JakubBohunicky/RoboCup/2024/Photo/tsop_PCB_V1.png

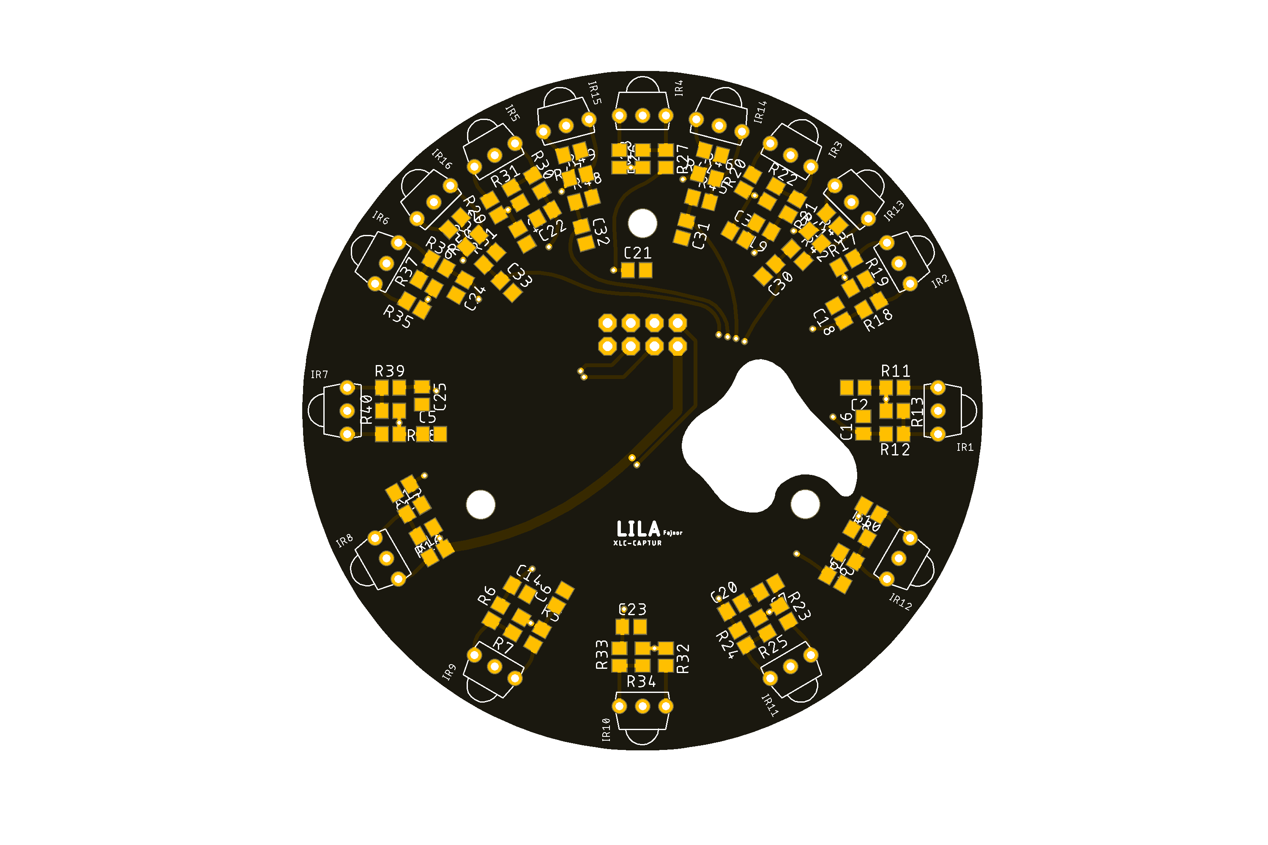
2024/Photo/tsop_PCB_V1.png
