JakubBohunicky/RoboCup/2025_Bari/test_code/tlaƒ/4ksclonynatsopnovaverzia.3mf

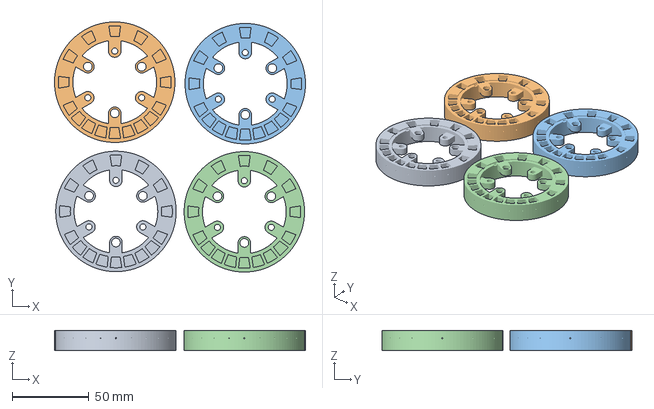
[picture p14: CAD file, 2026-10-10]
2025_Bari/test_code/tlaƒ/4ksclonynatsopnovaverzia.3mf
163.9 x 163.3 x 13.3 mm
