JakubBohunicky/RoboCup/2025_Bari/test_code/tlaƒ/kickerkolecka.3mf

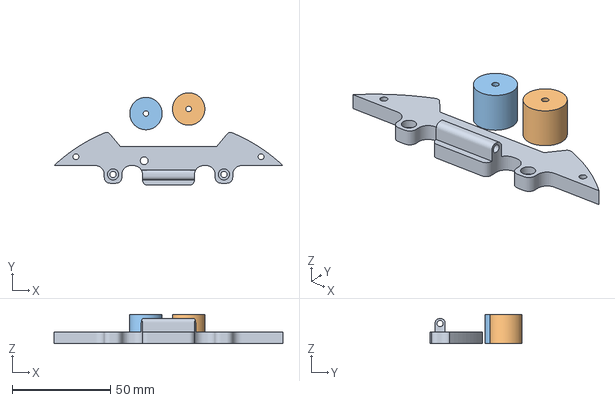
[picture p15: CAD file, 2026-10-10]
2025_Bari/test_code/tlaƒ/kickerkolecka.3mf
116.5 x 47.0 x 15.0 mm
Body59.stl
vnutronakolieskodriblera_
