JakubBohunicky/RoboCup/2025_Bari/test_code/tlaƒ/kicker.3mf

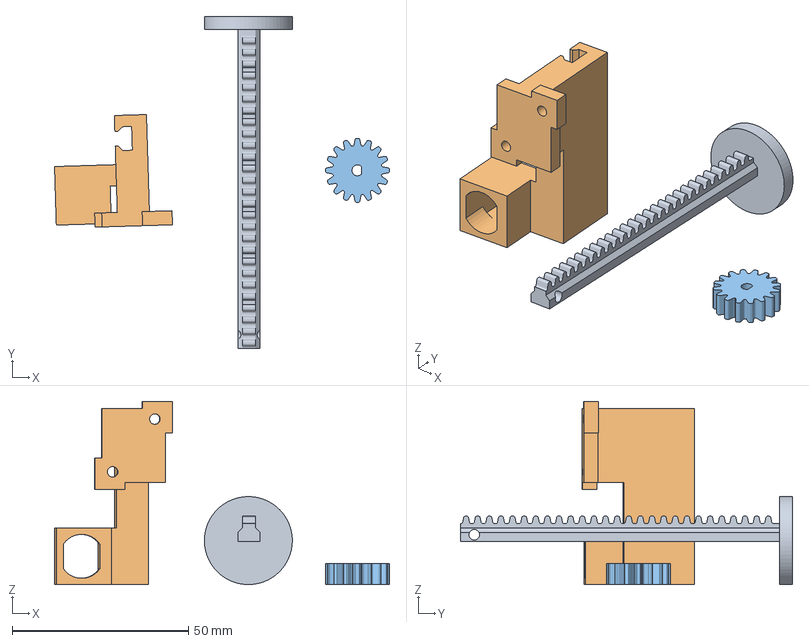
[picture p16: CAD file, 2026-10-10]
2025_Bari/test_code/tlaƒ/kicker.3mf
95.2 x 94.4 x 52.0 mm
Body10.stl
testnakicker v10
testkicker v4
