JakubBohunicky/RoboCup/2025_Bari/test_code/tlaƒ/radlica.3mf

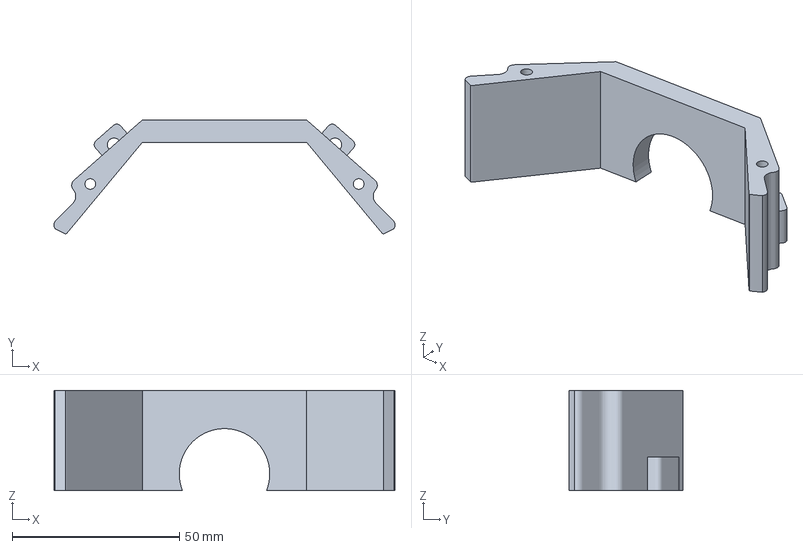
[picture p17: CAD file, 2026-10-10]
2025_Bari/test_code/tlaƒ/radlica.3mf
101.8 x 34.0 x 29.9 mm
