JakubBohunicky/RoboCup/2025_Bari/test_code/tlaƒ/drziaknakameru.3mf

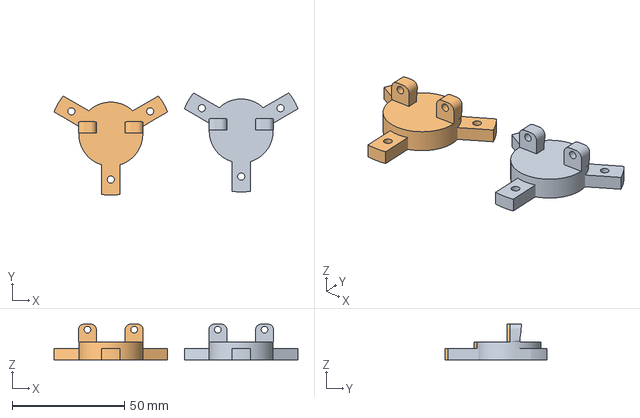
[picture p18: CAD file, 2026-10-10]
2025_Bari/test_code/tlaƒ/drziaknakameru.3mf
108.9 x 45.6 x 16.0 mm
