JakubBohunicky/RoboCup/(list of files, cad)

Other CAD files:
2024/lnx/Hardware/Mechanics/lnx_main.step
2026_Korea/3D_model/2_Top_PCB.stp
2026_Korea/3D_model/1_Bottom_PCB.stp
2026_Korea/3D_model/1_Bottom_PCB.f3d
2026_Korea/3D_model/2_Top_PCB.f3d
