JakubBohunicky/RoboCup/2026_Korea/Escon/MOVEMENT/escon-24-2mod_wiring_blank_landscape.jpg

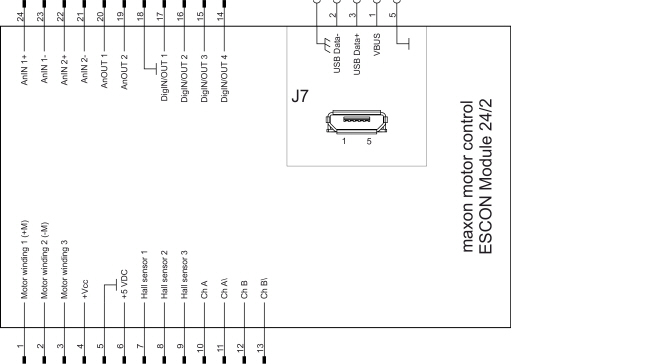
2026_Korea/Escon/MOVEMENT/escon-24-2mod_wiring_blank_landscape.jpg
