JakubBohunicky/RoboCup/2026_Slovakia/codeChanges.txt

bariCode (ferrari x chladic)
{
	original code from bari - Ferrari was sped up	
}

diddyCodeV1 (ferrari) 
{
	checkpoint for V2 - changed line behavior when near ball, but only on ferrari and I slowed it down  
}

diddyCodeV2 (ferrari x chladic)
{
	xxxxxx---- working code ------xxxxxx
	-changed behavior of ball capturing when near line

	-added gyro calibration

}
