JakubBohunicky/RoboCup/2024/XLC-Captur_Github/PCBs/upper_pcb.brd

## EAGLE design 2024/XLC-Captur_Github/PCBs/upper_pcb.brd (2026-09-25)

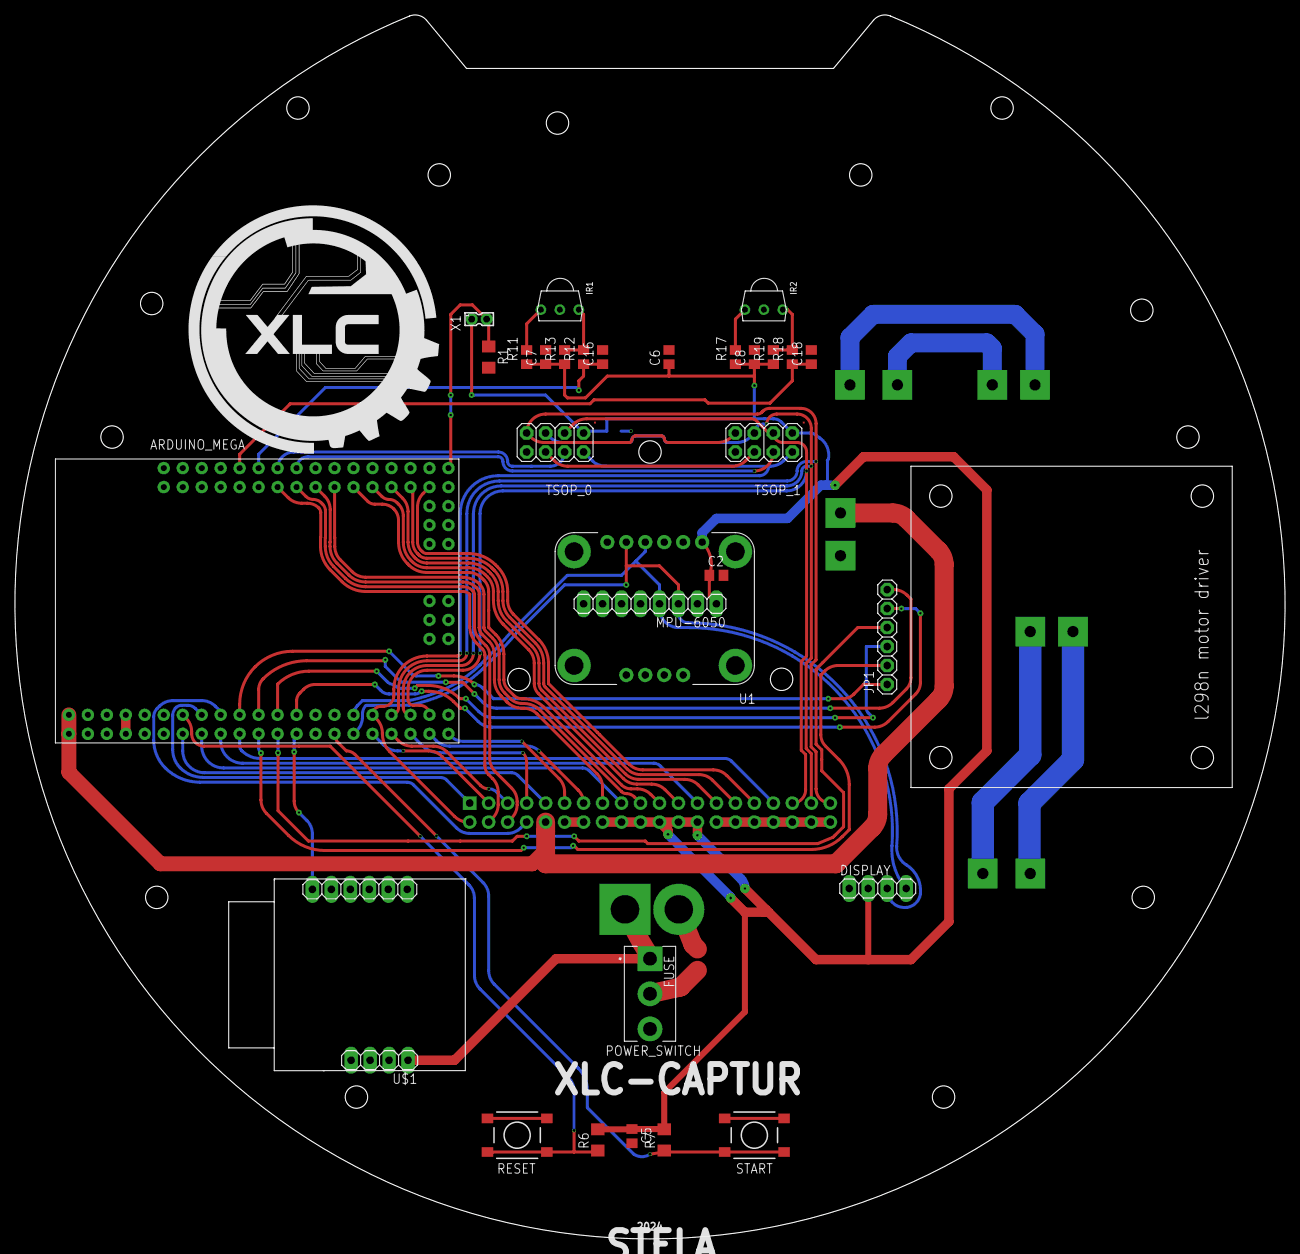
[picture p20: board upper_pcb.brd from above]

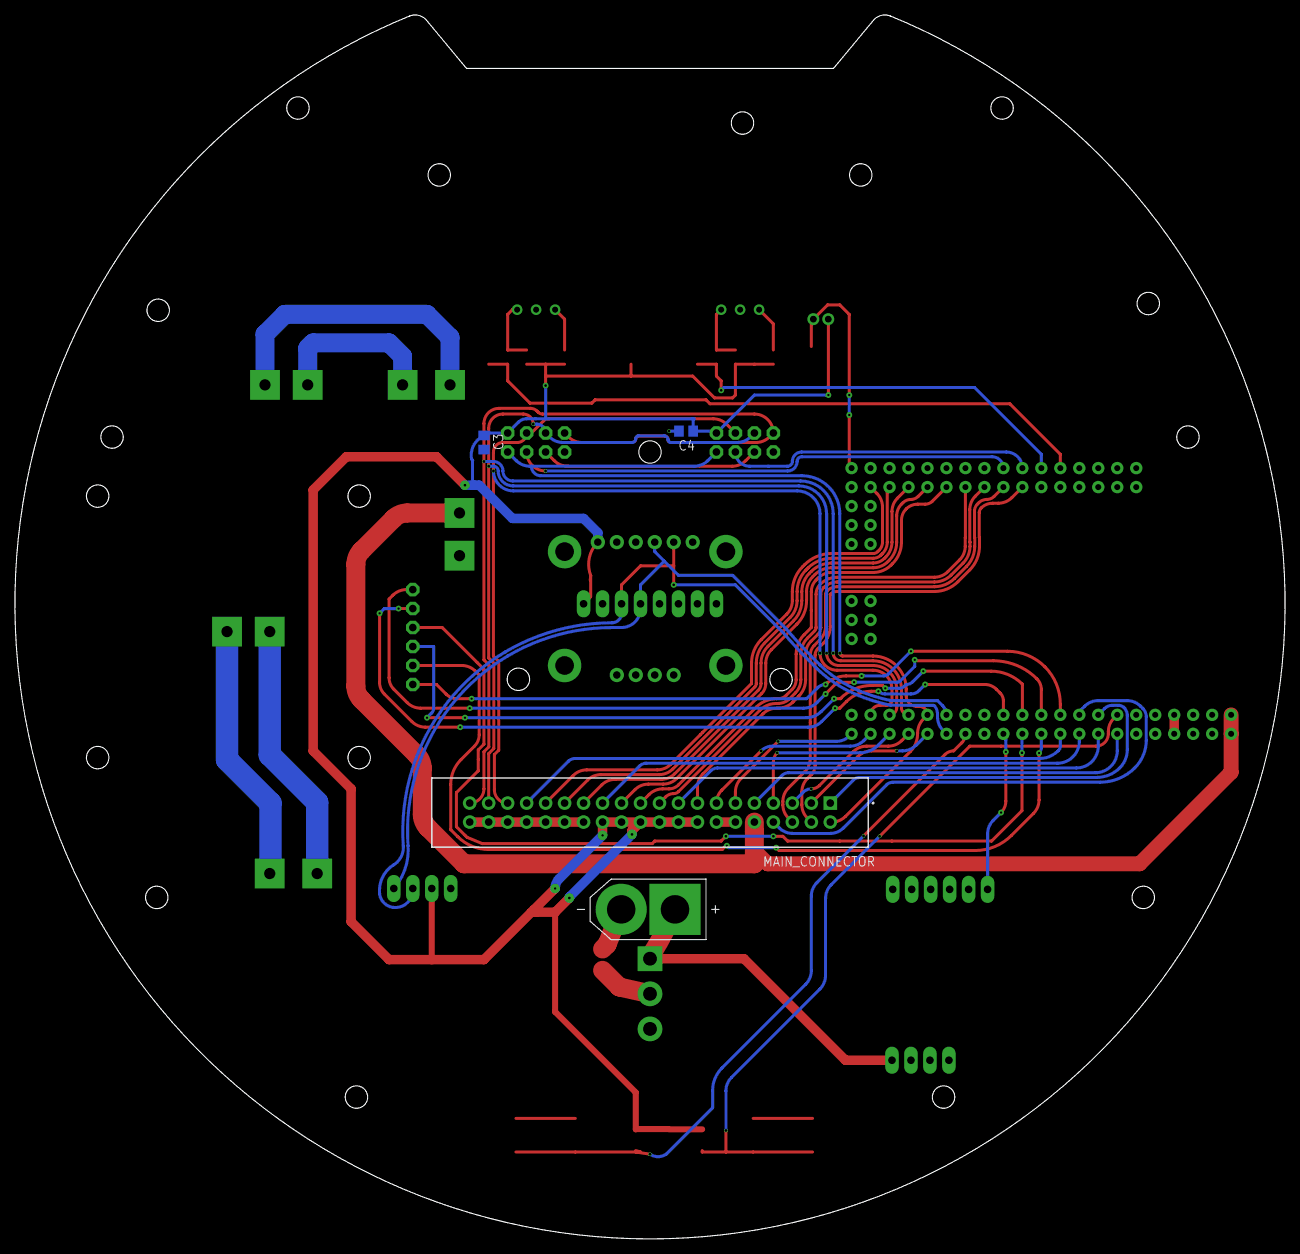
[picture p21: board upper_pcb.brd from below]

Board: 2 copper layers, 170.0 x 163.8 mm, 46 parts (4 on the bottom side), 58 nets.

Parts:
ARDUINO_MEGA: MEGA_PRO_EMBED_CH340G_/_ATMEGA2560; MODULE_MEGA_PRO_EMBED_CH340G_/_ATMEGA2560
C2, C3, C4, C5, C6, C7, C8: 100nF; C0805
C16: C0805
C18: 1u; C0805
DISPLAY: 1X04
FUSE: R1206
IR1, IR2: TSSP58038; TSOP
J2: XT60-M; AMASS_XT60-M
JP1: 1X06
MAIN_CONNECTOR: TST-120-02-S-D; SAMTEC_TST-120-02-S-D
MPU-6050: 1X08
POWER_SWITCH: 100SP1T1B4M2QE; SW_100SP1T1B4M2QE
R1, R6, R7: 10K; R1206
R11, R12, R13: R0805
R17: 10R; R0805
R18: 100k; R0805
R19: 4.7k; R0805
RESET: DTSM-6
START: DTSM-6
TSOP_0, TSOP_1: 2X04
U1: 2472; MODULE_2472
U$1: ROBOCUP_MODULE
U$2: L298NMOTORDRIVER
U$3, U$4, U$5, U$6, U$7, U$8, U$9, U$10, U$11, U$12: PAD_MOTORS
X1: 332-02

Connections:
3V3: ARDUINO_MEGA.3V3_1, ARDUINO_MEGA.3V3_2
5V: ARDUINO_MEGA.5V_1, ARDUINO_MEGA.5V_2, ARDUINO_MEGA.5V_3
+3V3: MAIN_CONNECTOR.12, MAIN_CONNECTOR.14
+5V: C2.1, C3.1, C4.1, C5.1, C6.1, C7.1, C8.1, DISPLAY.2, MAIN_CONNECTOR.16, MAIN_CONNECTOR.18, MAIN_CONNECTOR.20, MAIN_CONNECTOR.22, MAIN_CONNECTOR.24, MAIN_CONNECTOR.26, MPU-6050.1, R6.2, R7.2, R11.1, R13.1, R17.1, R19.1, TSOP_0.1, TSOP_1.1, U1.1, X1.1
+12V: ARDUINO_MEGA.VIN_1, ARDUINO_MEGA.VIN_2, MAIN_CONNECTOR.10, U$7.P$2
BUTTON_KICK: ARDUINO_MEGA.D46, R1.1, X1.2
DIG_OUT: ARDUINO_MEGA.D15, U$1.10
DRIBLER+: U$5.P$2, U$11.P$2
DRIBLER-: U$6.P$2, U$12.P$2
EN1: ARDUINO_MEGA.D8, JP1.1
EN2: ARDUINO_MEGA.D10, JP1.6
EN_A: ARDUINO_MEGA.D23, MAIN_CONNECTOR.03
EN_B: ARDUINO_MEGA.D31, MAIN_CONNECTOR.11
EN_C: ARDUINO_MEGA.D35, MAIN_CONNECTOR.19
EN_D: ARDUINO_MEGA.D41, MAIN_CONNECTOR.27
GND: ARDUINO_MEGA.GND_1, ARDUINO_MEGA.GND_2, ARDUINO_MEGA.GND_3, C2.2, C3.2, C4.2, C5.2, C6.2, C7.2, C8.2, C16.2, C18.2, DISPLAY.1, IR1.GND, IR2.GND, MAIN_CONNECTOR.28, MAIN_CONNECTOR.30, MAIN_CONNECTOR.32, MAIN_CONNECTOR.34, MAIN_CONNECTOR.36, MAIN_CONNECTOR.38, MAIN_CONNECTOR.40, MPU-6050.2, R1.2, RESET.3, RESET.4, START.3, START.4, TSOP_0.8, TSOP_1.8, U1.3, U$1.4, U$8.P$2
GYRO_SCL: ARDUINO_MEGA.D21, DISPLAY.3, MPU-6050.3, U1.5
GYRO_SDA: ARDUINO_MEGA.D20, DISPLAY.4, MPU-6050.4, U1.4
I0: ARDUINO_MEGA.A10, C16.1, R12.1
I1: ARDUINO_MEGA.A8, C18.1, R18.1
IN1: ARDUINO_MEGA.D11, JP1.2
IN1_A: ARDUINO_MEGA.D25, MAIN_CONNECTOR.05
IN1_B: ARDUINO_MEGA.D29, MAIN_CONNECTOR.13
IN1_C: ARDUINO_MEGA.D37, MAIN_CONNECTOR.21
IN1_D: ARDUINO_MEGA.D43, MAIN_CONNECTOR.29
IN2: ARDUINO_MEGA.D12, JP1.3
IN2_A: ARDUINO_MEGA.D27, MAIN_CONNECTOR.07
IN2_B: ARDUINO_MEGA.D33, MAIN_CONNECTOR.15
IN2_C: ARDUINO_MEGA.D39, MAIN_CONNECTOR.23
IN2_D: ARDUINO_MEGA.D45, MAIN_CONNECTOR.31
IN3: ARDUINO_MEGA.D13, JP1.4
IN4: ARDUINO_MEGA.D14, JP1.5
IR_READ_A: ARDUINO_MEGA.A12, TSOP_0.4
IR_READ_B: ARDUINO_MEGA.A14, TSOP_1.4
KICK+: U$3.P$2, U$9.P$2
KICK-: U$4.P$2, U$10.P$2
KICKER: ARDUINO_MEGA.D4, MAIN_CONNECTOR.01
LED_ENABLE: ARDUINO_MEGA.D6, MAIN_CONNECTOR.08
LED_UP: TSOP_0.6, TSOP_1.6
LIGHT_READ_A: ARDUINO_MEGA.A13, MAIN_CONNECTOR.04
LIGHT_READ_B: ARDUINO_MEGA.A15, MAIN_CONNECTOR.06
LIGHT_SET_0: ARDUINO_MEGA.D28, MAIN_CONNECTOR.35, TSOP_0.3, TSOP_1.3
LIGHT_SET_1: ARDUINO_MEGA.D26, MAIN_CONNECTOR.37, TSOP_0.5, TSOP_1.5
LIGHT_SET_2: ARDUINO_MEGA.D24, MAIN_CONNECTOR.39, TSOP_0.7, TSOP_1.7
LIGHT_SET_3: ARDUINO_MEGA.D22, MAIN_CONNECTOR.02, TSOP_0.2, TSOP_1.2
unnamed: FUSE.2, POWER_SWITCH.2
unnamed: J2.P, POWER_SWITCH.1, U$1.1
unnamed: FUSE.1, J2.N
unnamed: IR1.VS, R11.2
unnamed: IR2.VS, R17.2
unnamed: IR1.VO, R12.2, R13.2
unnamed: IR2.VO, R18.2, R19.2
PWM_A: ARDUINO_MEGA.D3, MAIN_CONNECTOR.09
PWM_B: ARDUINO_MEGA.D5, MAIN_CONNECTOR.17
PWM_C: ARDUINO_MEGA.D7, MAIN_CONNECTOR.25
PWM_D: ARDUINO_MEGA.D9, MAIN_CONNECTOR.33
RESET_SWITCH: ARDUINO_MEGA.D2, R6.1, RESET.1, RESET.2
START_SWITCH: ARDUINO_MEGA.D19, R7.1, START.1, START.2
