JakubBohunicky/RoboCup/2024/simonov_open_2024/Simon/lower_base.sch

## EAGLE design 2024/simonov_open_2024/Simon/lower_base.sch (2026-09-25)

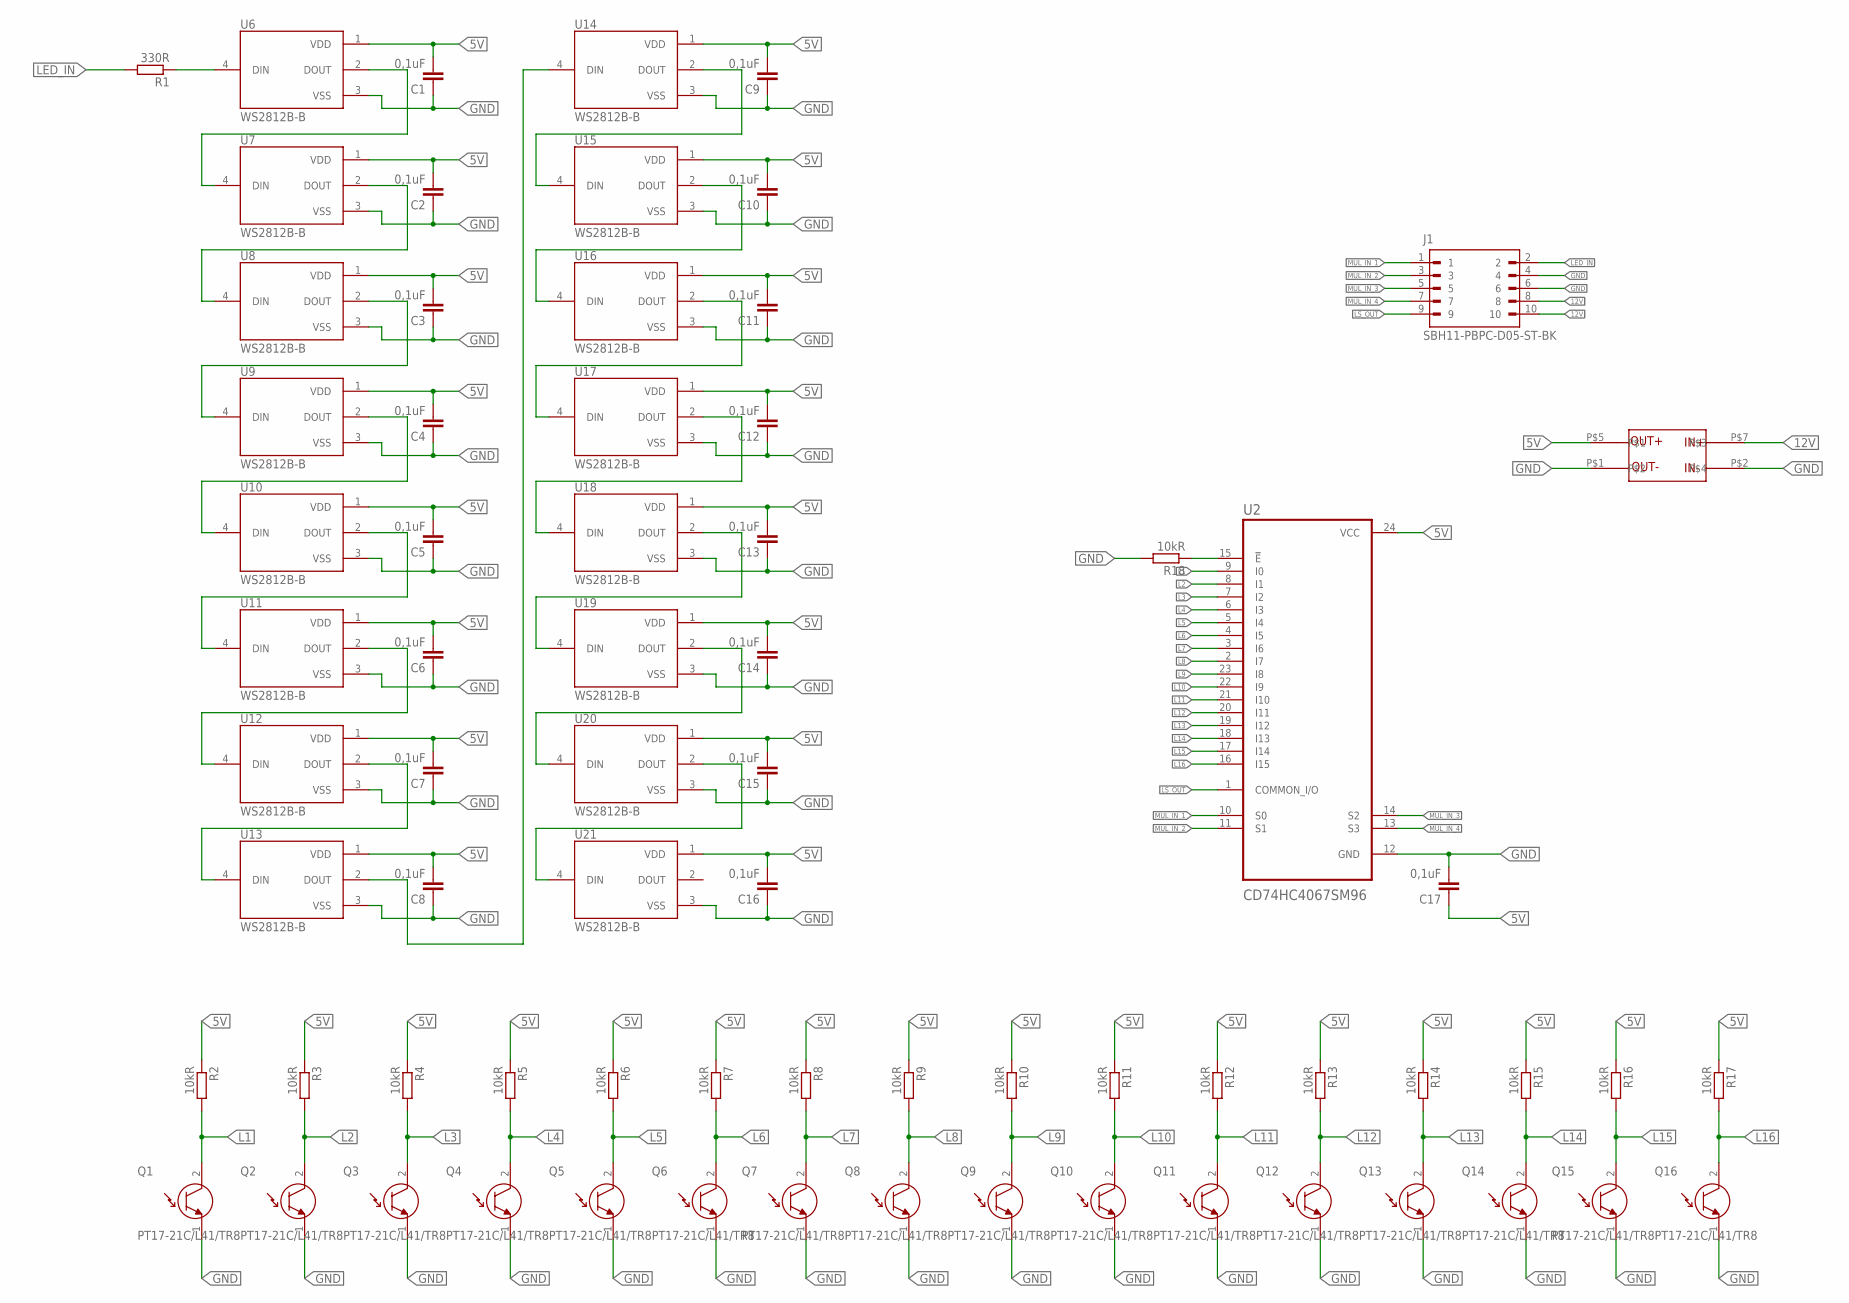
[picture p22: schematic lower_base.sch]

Parts:
C1, C2, C3, C4, C5, C6, C7, C8, C9, C10, C11, C12, C13, C14, C15, C16, C17: 0,1uF; C0805
J1: SBH11-PBPC-D05-ST-BK; SULLINS_SBH11-PBPC-D05-ST-BK
Q1, Q2, Q3, Q4, Q5, Q6, Q7, Q8, Q9, Q10, Q11, Q12, Q13, Q14, Q15, Q16: PT17-21C/L41/TR8; OPTO_PT17-21C/L41/TR8
R1: 330R; R0805
R2, R3, R4, R5, R6, R7, R8, R9, R10, R11, R12, R13, R14, R15, R16, R17, R18: 10kR; R0805
U2: CD74HC4067SM96; SOP65P780X200-24N
U6, U7, U8, U9, U10, U11, U12, U13, U14, U15, U16, U17, U18, U19, U20, U21: WS2812B-B; LED_WS2812B-B
U$1: REGULATOR_3A_MINI; REGULATOR_3A_MIN

Connections:
5V: C1.2, C2.2, C3.2, C4.2, C5.2, C6.2, C7.2, C8.2, C9.2, C10.2, C11.2, C12.2, C13.2, C14.2, C15.2, C16.2, C17.1, R2.1, R3.1, R4.1, R5.1, R6.1, R7.1, R8.1, R9.1, R10.1, R11.1, R12.1, R13.1, R14.1, R15.1, R16.1, R17.1, U2.24 (VCC), U6.1 (VDD), U7.1 (VDD), U8.1 (VDD), U9.1 (VDD), U10.1 (VDD), U11.1 (VDD), U12.1 (VDD), U13.1 (VDD), U14.1 (VDD), U15.1 (VDD), U16.1 (VDD), U17.1 (VDD), U18.1 (VDD), U19.1 (VDD), U20.1 (VDD), U21.1 (VDD), U$1.P$5
12V: J1.8, J1.10, U$1.P$7
GND: C1.1, C2.1, C3.1, C4.1, C5.1, C6.1, C7.1, C8.1, C9.1, C10.1, C11.1, C12.1, C13.1, C14.1, C15.1, C16.1, C17.2, J1.4, J1.6, Q1.1 (ET), Q2.1 (ET), Q3.1 (ET), Q4.1 (ET), Q5.1 (ET), Q6.1 (ET), Q7.1 (ET), Q8.1 (ET), Q9.1 (ET), Q10.1 (ET), Q11.1 (ET), Q12.1 (ET), Q13.1 (ET), Q14.1 (ET), Q15.1 (ET), Q16.1 (ET), R18.2, U2.12 (GND), U6.3 (VSS), U7.3 (VSS), U8.3 (VSS), U9.3 (VSS), U10.3 (VSS), U11.3 (VSS), U12.3 (VSS), U13.3 (VSS), U14.3 (VSS), U15.3 (VSS), U16.3 (VSS), U17.3 (VSS), U18.3 (VSS), U19.3 (VSS), U20.3 (VSS), U21.3 (VSS), U$1.P$1, U$1.P$2
L1: Q1.2 (CT), R2.2, U2.9 (I0)
L2: Q2.2 (CT), R3.2, U2.8 (I1)
L3: Q3.2 (CT), R4.2, U2.7 (I2)
L4: Q4.2 (CT), R5.2, U2.6 (I3)
L5: Q5.2 (CT), R6.2, U2.5 (I4)
L6: Q6.2 (CT), R7.2, U2.4 (I5)
L7: Q7.2 (CT), R8.2, U2.3 (I6)
L8: Q8.2 (CT), R9.2, U2.2 (I7)
L9: Q9.2 (CT), R10.2, U2.23 (I8)
L10: Q10.2 (CT), R11.2, U2.22 (I9)
L11: Q11.2 (CT), R12.2, U2.21 (I10)
L12: Q12.2 (CT), R13.2, U2.20 (I11)
L13: Q13.2 (CT), R14.2, U2.19 (I12)
L14: Q14.2 (CT), R15.2, U2.18 (I13)
L15: Q15.2 (CT), R16.2, U2.17 (I14)
L16: Q16.2 (CT), R17.2, U2.16 (I15)
LED_IN: J1.2, R1.2
LS_OUT: J1.9, U2.1 (COMMON_I/O)
MUL_IN_1: J1.1, U2.10 (S0)
MUL_IN_2: J1.3, U2.11 (S1)
MUL_IN_3: J1.5, U2.14 (S2)
MUL_IN_4: J1.7, U2.13 (S3)
unnamed: R1.1, U6.4 (DIN)
unnamed: U6.2 (DOUT), U7.4 (DIN)
unnamed: U7.2 (DOUT), U8.4 (DIN)
unnamed: U8.2 (DOUT), U9.4 (DIN)
unnamed: U9.2 (DOUT), U10.4 (DIN)
unnamed: U10.2 (DOUT), U11.4 (DIN)
unnamed: U11.2 (DOUT), U12.4 (DIN)
unnamed: U12.2 (DOUT), U13.4 (DIN)
unnamed: U13.2 (DOUT), U14.4 (DIN)
unnamed: U17.2 (DOUT), U18.4 (DIN)
unnamed: U18.2 (DOUT), U19.4 (DIN)
unnamed: U14.2 (DOUT), U15.4 (DIN)
unnamed: U15.2 (DOUT), U16.4 (DIN)
unnamed: U16.2 (DOUT), U17.4 (DIN)
unnamed: U19.2 (DOUT), U20.4 (DIN)
unnamed: U20.2 (DOUT), U21.4 (DIN)
unnamed: R18.1, U2.15 (!E)
