JakubBohunicky/RoboCup/2025_Bari/test_code/xlc suro/new_horna_podstava.sch

## EAGLE design 2025_Bari/test_code/xlc suro/new_horna_podstava.sch (2026-10-10)

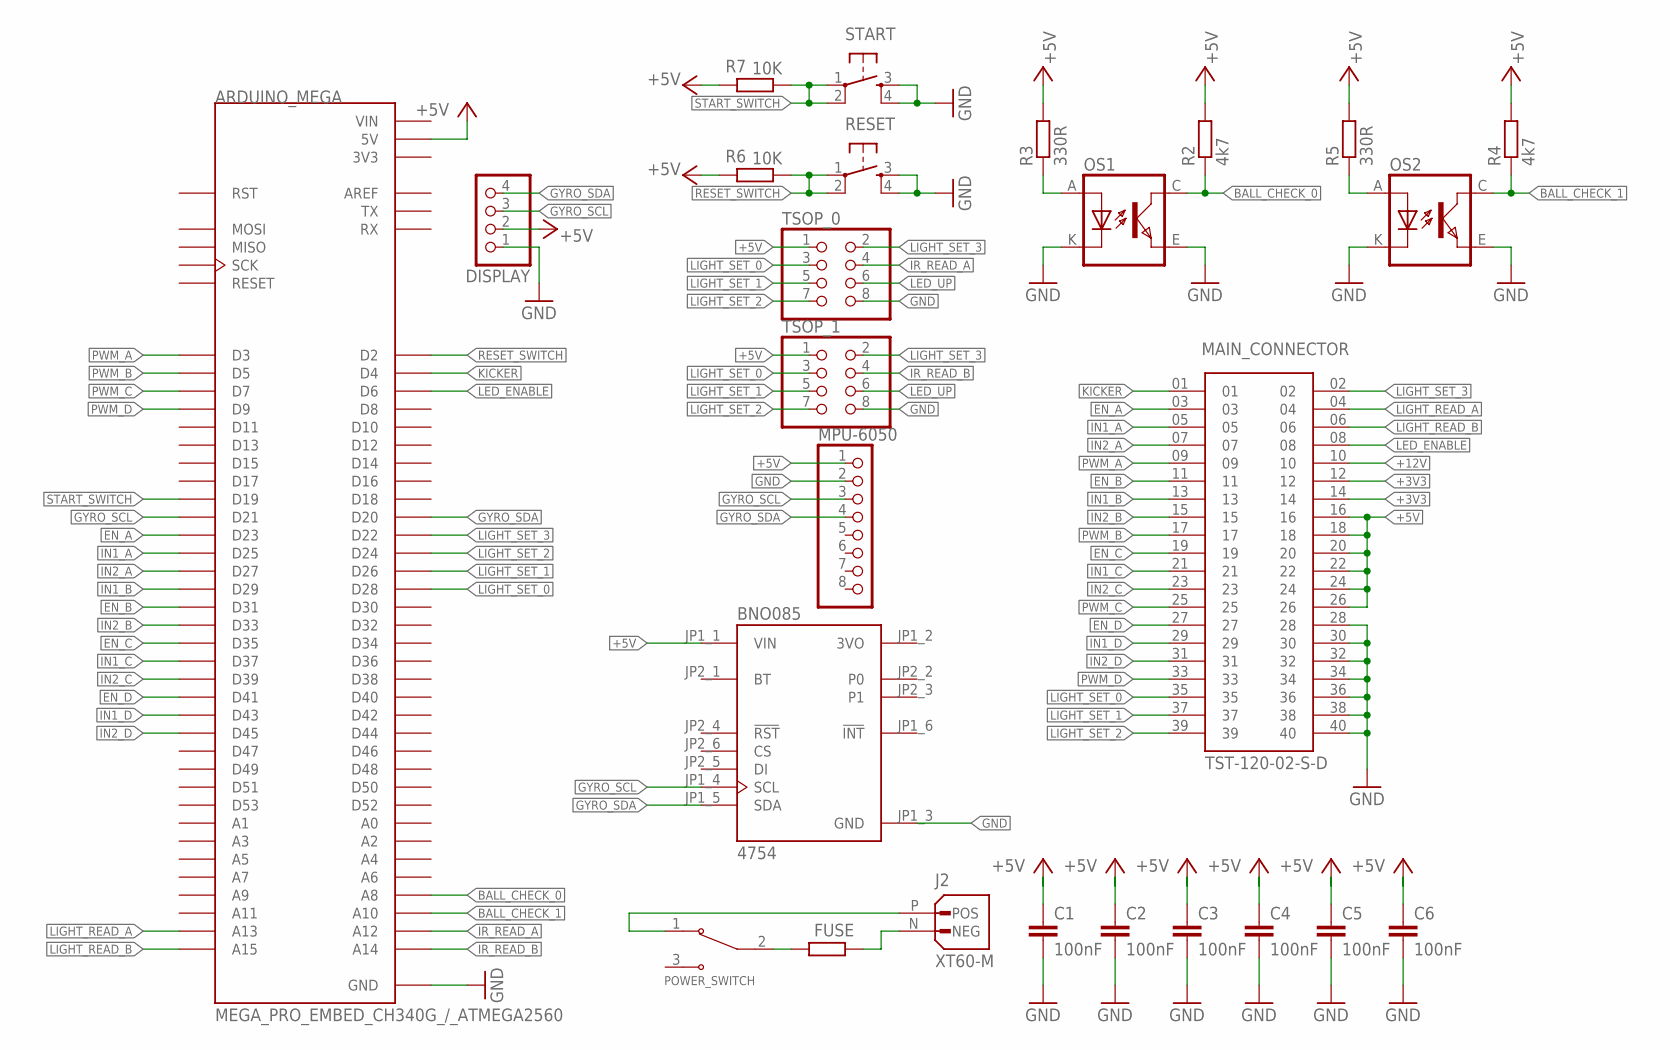
[picture p23: schematic new_horna_podstava.sch]

Parts:
ARDUINO_MEGA: MEGA_PRO_EMBED_CH340G_/_ATMEGA2560; MODULE_MEGA_PRO_EMBED_CH340G_/_ATMEGA2560
BNO085: 4754; MODULE_4754
C1, C2, C3, C4, C5, C6: 100nF; C0805
DISPLAY: PINHD-1X4; 1X04
FUSE: R-EU_R1206; R1206
J2: XT60-M; AMASS_XT60-M
MAIN_CONNECTOR: TST-120-02-S-D; SAMTEC_TST-120-02-S-D
MPU-6050: PINHD-1X8; 1X08
OS1, OS2: TCRT5000
POWER_SWITCH: 100SP1T1B4M2QE; SW_100SP1T1B4M2QE
R2, R4: 4k7; R1206
R3, R5: 330R; R1206
R6, R7: 10K; R1206
RESET: DTSM-6
START: DTSM-6
TSOP_0, TSOP_1: PINHD-2X4; 2X04

Connections:
+3V3: MAIN_CONNECTOR.12, MAIN_CONNECTOR.14
+5V: ARDUINO_MEGA.5V_1 (5V), BNO085.JP1_1 (VIN), C1.1, C2.1, C3.1, C4.1, C5.1, C6.1, DISPLAY.2, MAIN_CONNECTOR.16, MAIN_CONNECTOR.18, MAIN_CONNECTOR.20, MAIN_CONNECTOR.22, MAIN_CONNECTOR.24, MAIN_CONNECTOR.26, MPU-6050.1, R2.2, R3.2, R4.2, R5.2, R6.2, R7.2, TSOP_0.1, TSOP_1.1
+12V: MAIN_CONNECTOR.10
BALL_CHECK_0: ARDUINO_MEGA.A8, OS1.C (COLLECTOR), R2.1
BALL_CHECK_1: ARDUINO_MEGA.A10, OS2.C (COLLECTOR), R4.1
EN_A: ARDUINO_MEGA.D23, MAIN_CONNECTOR.03
EN_B: ARDUINO_MEGA.D31, MAIN_CONNECTOR.11
EN_C: ARDUINO_MEGA.D35, MAIN_CONNECTOR.19
EN_D: ARDUINO_MEGA.D41, MAIN_CONNECTOR.27
GND: ARDUINO_MEGA.GND_1 (GND), BNO085.JP1_3 (GND), C1.2, C2.2, C3.2, C4.2, C5.2, C6.2, DISPLAY.1, MAIN_CONNECTOR.28, MAIN_CONNECTOR.30, MAIN_CONNECTOR.32, MAIN_CONNECTOR.34, MAIN_CONNECTOR.36, MAIN_CONNECTOR.38, MAIN_CONNECTOR.40, MPU-6050.2, OS1.E (EMITTER), OS1.K (CATHODE), OS2.E (EMITTER), OS2.K (CATHODE), RESET.3, RESET.4, START.3, START.4, TSOP_0.8, TSOP_1.8
GYRO_SCL: ARDUINO_MEGA.D21, BNO085.JP1_4 (SCL), DISPLAY.3, MPU-6050.3
GYRO_SDA: ARDUINO_MEGA.D20, BNO085.JP1_5 (SDA), DISPLAY.4, MPU-6050.4
IN1_A: ARDUINO_MEGA.D25, MAIN_CONNECTOR.05
IN1_B: ARDUINO_MEGA.D29, MAIN_CONNECTOR.13
IN1_C: ARDUINO_MEGA.D37, MAIN_CONNECTOR.21
IN1_D: ARDUINO_MEGA.D43, MAIN_CONNECTOR.29
IN2_A: ARDUINO_MEGA.D27, MAIN_CONNECTOR.07
IN2_B: ARDUINO_MEGA.D33, MAIN_CONNECTOR.15
IN2_C: ARDUINO_MEGA.D39, MAIN_CONNECTOR.23
IN2_D: ARDUINO_MEGA.D45, MAIN_CONNECTOR.31
IR_READ_A: ARDUINO_MEGA.A12, TSOP_0.4
IR_READ_B: ARDUINO_MEGA.A14, TSOP_1.4
KICKER: ARDUINO_MEGA.D4, MAIN_CONNECTOR.01
LED_ENABLE: ARDUINO_MEGA.D6, MAIN_CONNECTOR.08
LED_UP: TSOP_0.6, TSOP_1.6
LIGHT_READ_A: ARDUINO_MEGA.A13, MAIN_CONNECTOR.04
LIGHT_READ_B: ARDUINO_MEGA.A15, MAIN_CONNECTOR.06
LIGHT_SET_0: ARDUINO_MEGA.D28, MAIN_CONNECTOR.35, TSOP_0.3, TSOP_1.3
LIGHT_SET_1: ARDUINO_MEGA.D26, MAIN_CONNECTOR.37, TSOP_0.5, TSOP_1.5
LIGHT_SET_2: ARDUINO_MEGA.D24, MAIN_CONNECTOR.39, TSOP_0.7, TSOP_1.7
LIGHT_SET_3: ARDUINO_MEGA.D22, MAIN_CONNECTOR.02, TSOP_0.2, TSOP_1.2
unnamed: FUSE.2, POWER_SWITCH.2
unnamed: J2.P (POS), POWER_SWITCH.1
unnamed: FUSE.1, J2.N (NEG)
unnamed: OS2.A (ANODE), R5.1
unnamed: OS1.A (ANODE), R3.1
PWM_A: ARDUINO_MEGA.D3, MAIN_CONNECTOR.09
PWM_B: ARDUINO_MEGA.D5, MAIN_CONNECTOR.17
PWM_C: ARDUINO_MEGA.D7, MAIN_CONNECTOR.25
PWM_D: ARDUINO_MEGA.D9, MAIN_CONNECTOR.33
RESET_SWITCH: ARDUINO_MEGA.D2, R6.1, RESET.1, RESET.2
START_SWITCH: ARDUINO_MEGA.D19, R7.1, START.1, START.2
