JakubBohunicky/RoboCup/(commit log)

2026-10-10 Reorganise repo, add 2026_Korea robot, READMEs and MIT license
    - Rename 2026_Kim-Min-seok to 2026_Korea (ESP32-S3 robot, Incheon 2026)
    - Move other teams' code, drafts and personal files to _private/
    - Add READMEs for every robot and an MIT LICENSE
    - Add repo .gitignore (_private/, .pio/, Eagle backups)
    - Fix case-sensitive include in input_line.cpp (Linux build)
2026-10-16 Add 2026_Korea PCBs, 3D models and poster
    Full assembly (3D+model.stp/.f3z) is over GitHub's 100 MB limit and goes
    to the korea-2026-3d release instead.
